PiotrOstrowski05/projekt-podnosnika-dwuramiennego/README.md

# Projekt: Ręczny podnośnik samochodowy dwuramienny

## Opis projektu
Projekt obejmuje kompleksowe opracowanie inżynierskie ręcznego podnośnika śrubowego. Proces projektowy został przeprowadzony od fazy koncepcyjnej i obliczeniowej, aż po stworzenie pełnej dokumentacji technicznej gotowej do wytworzenia.

## Zakres opracowania

### 1. Analiza teoretyczna i obliczenia
* **Wyznaczenie obciążeń:** Przeprowadzenie obliczeń analitycznych w celu określenia sił działających na poszczególne ogniwa mechanizmu w pełnym zakresie ruchu.
* **Weryfikacja wytrzymałościowa:** Dobór parametrów gwintu śruby napędowej (sprawdzenie na samohamowność i naciski powierzchniowe) oraz wymiarowanie sworzni i ramion pod kątem naprężeń gnących i ścinających.

### 2. Modelowanie CAD (Siemens NX)
* **Modelowanie bryłowe:** Stworzenie precyzyjnych modeli 3D wszystkich komponentów urządzenia.
* **Złożenie (Assembly):** Budowa struktury złożenia z uwzględnieniem więzów kinematycznych, pozwalających na symulację pracy podnośnika.
* **Dobór części znormalizowanych:** Implementacja elementów takich jak podkładki, pierścienie osadcze i elementy złączne zgodnie z normami PN/ISO.

### 3. Dokumentacja techniczna
* **Rysunki wykonawcze:** Opracowanie dokumentacji 2D dla części wymagających obróbki (np. sworznie, ramiona).
* **Rysunek złożeniowy:** Przygotowanie widoku złożeniowego wraz z naniesionymi numerami pozycji i kompletną listą części (BOM).
* **Standardy:** Uwzględnienie pasowań, tolerancji wymiarowych oraz oznaczeń chropowatości powierzchni.

## Wykorzystane narzędzia
* **Siemens NX** (CAD, Drafting)
* **Metody analityczne** (Wytrzymałość materiałów, PKM)
