PiotrOstrowski05/projekt-podnosnika-dwuramiennego/Projekt podnosnika/Raport z projektowania podnosnika/Raport z projektowania dżwignika.pdf

# PKM IV

# PROJEKT DŹWIGNIKA DWURAMIENNEGO

Wydział Mechaniczny Energetyki i Lotnictwa

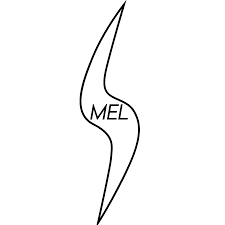
[picture p1: figure]

Piotr Ostrowski
Mechanika i Projektowanie Maszyn 333538

Sprawdzający:
mgr inż. Adam Wądołowski

## Spis treści

### 1.WSTĘP 2. STATYKA

2.1. Wyznaczenie sił działających na poszczególne ramiona i śrubę.
2.2. Rozkłady składowych wysiłku

### 3. OBLICZENIA WYTRZYMAŁOŚCIOWE

3.1. Wytrzymałość śruby
3.2. Wytrzymałość ramion
3.3. Wytrzymałość sworzni
3.4. Wytrzymałość nakrętki śruby napędowej 3.5 Wytrzymałość głowicy

### 4. DOBÓR ŁOŻYSKA WZDŁUŻNEGO 5. BIBLIOGRAFIA

### 1. WSTĘP

Celem projektu jest zaprojektowanie specjalistycznego, dwuramiennego dźwignika samochodowego, mającego za zadanie codziennej pracy w warsztacie samochodowym.

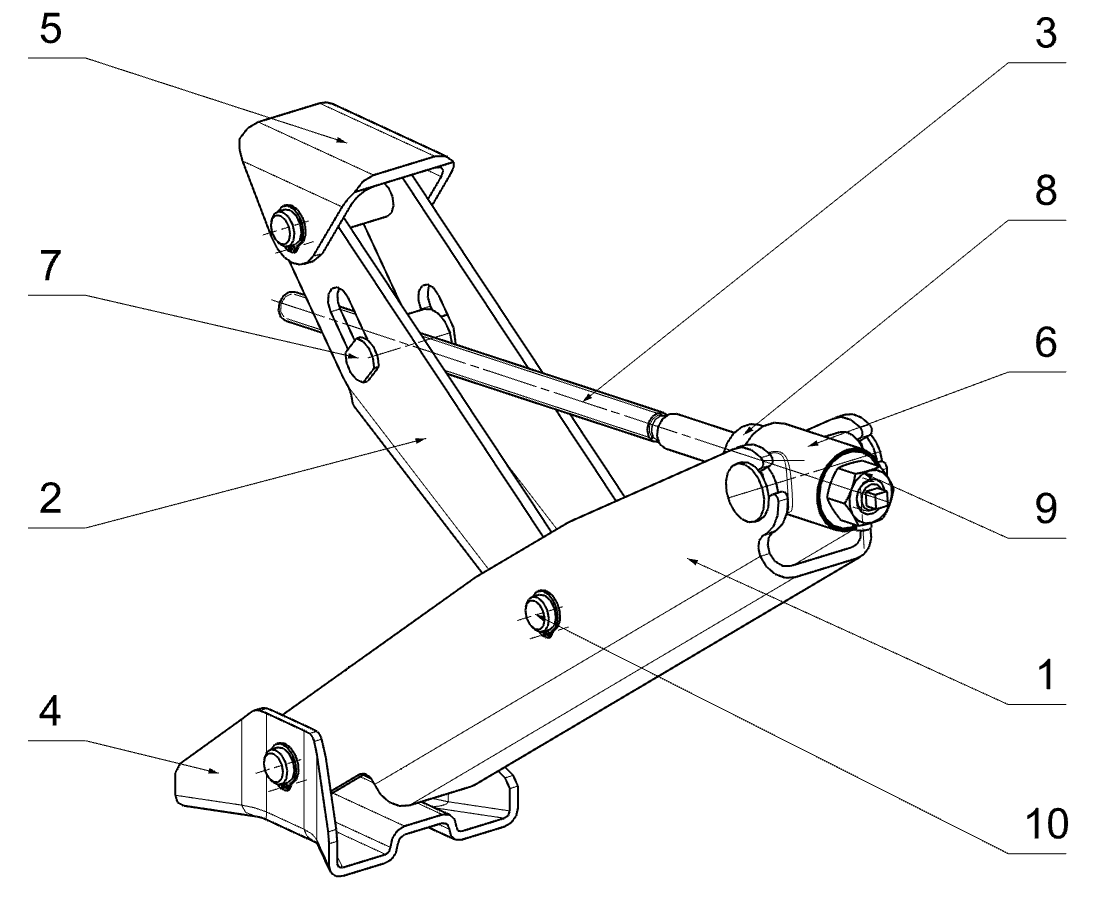
[picture p2: figure]

1 – Dłuższe ramię
2 – Krótsze ramię
3 – Śruba
4 – Podstawa
5 – Głowica
6 – Obudowa łożyska
7 - Nakrętka śruby napędzającej
8 – Pierścień osadczy
9 – Nakrętka sześciokątna (zmodyfikowana) 10 – sworzeń z pierścieniem Segera

Wymagania, które dźwignik musi spełnić:

Obciążenie maksymalne | Q | 4,4[kN]
Wysokość maksymalna | Hmax | 360[mm]
Wysokość na której dźwignik jest najbardziej obciążony | HQ | 240[mm]

Przeprowadzone obliczenia obejmują analizę wytrzymałości doraźnej oraz stateczności na wyboczenie wybranych elementów konstrukcyjnych. W obliczeniach pominięto wpływ zmęczenia materiału, przyjmując założenie, że liczba cykli pracy urządzenia jest niewielka.

Materiałem zastosowanym na ramiona jest stal C60, natomiast śruba podnośnika oraz pozostałe elementy przenoszące obciążenia wykonane są ze stali konstrukcyjnej C55. Charakterystyczne granice plastyczności materiałów wynoszą:
- stal S355J2: Re = 355 MPa
- stal S450JO: Re = 450 MPa

Ze względu na sprzyjające warunki eksploatacji, takie jak praca w środowisku warsztatowym o stabilnej temperaturze, brak niekorzystnych oddziaływań atmosferycznych oraz odpowiednie kwalifikacje personelu obsługującego, do dalszych obliczeń przyjęto współczynnik bezpieczeństwa o wartości x = 1,5.

Dźwignik w pozycji najbardziej rozłożonej

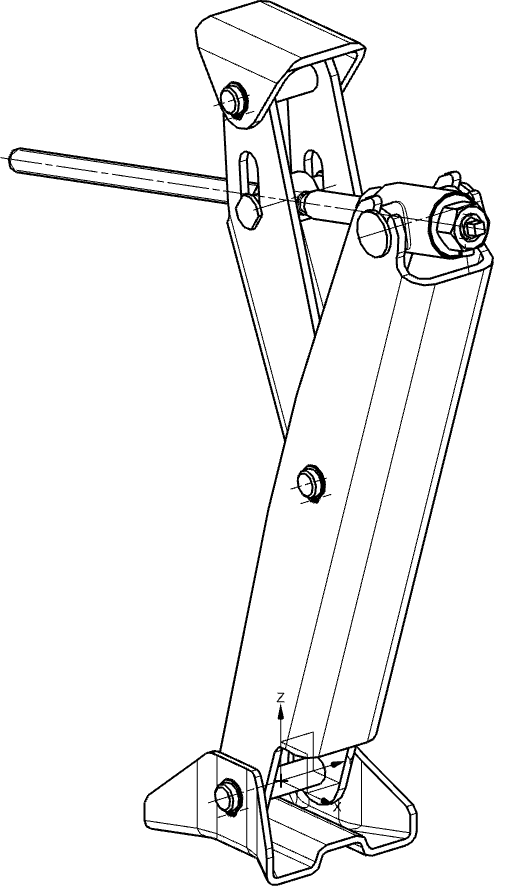
[picture p3: figure]

Dźwignik w pozycji najbardziej złożonej

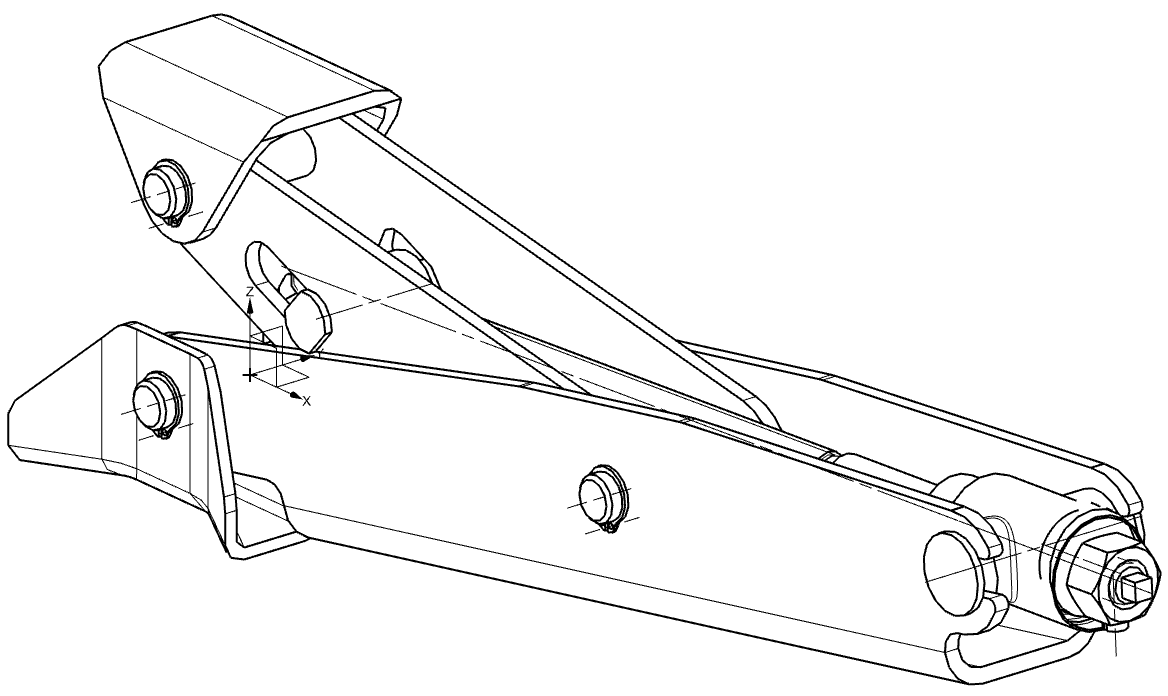
[picture p4: figure]

### 2. Statyka

2.1. Wyznaczenie sił działających na poszczególne ramiona i śrubę.

Uproszczony schemat dźwignika:

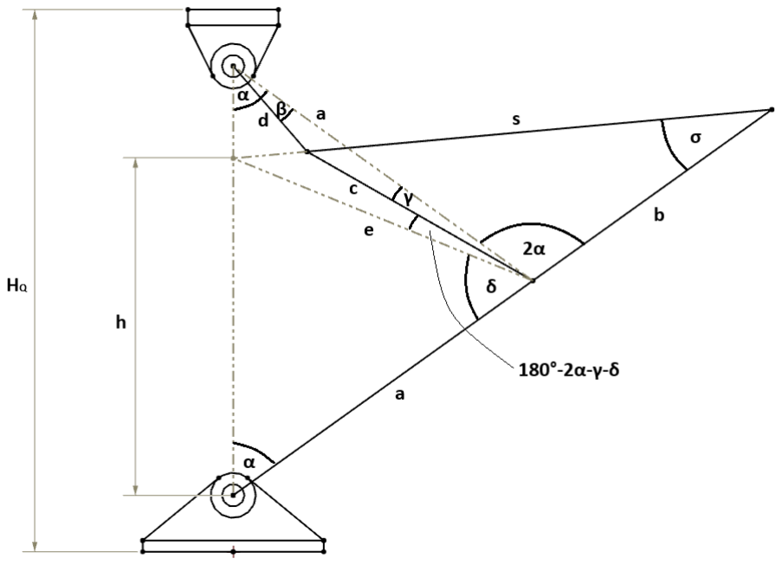
[picture p5: figure]

Obliczenia:
α = arccos(H/2)

s = √(c
2 + b

2 − 2cb cos(γ + 2α))

σ = arccos((−c

2 + s

2 + b

2
)/(2sb))

ℎ = sin(σ) ∗ (a + b)/(sin(180∘ − σ − α))

e = √(ℎ
2 + a

2 − 2ℎa cos(α))

δ = arccos((a

2 + e

2 − ℎ

2
)/(2ae))

Analiza sił obciążających dłuższe ramię

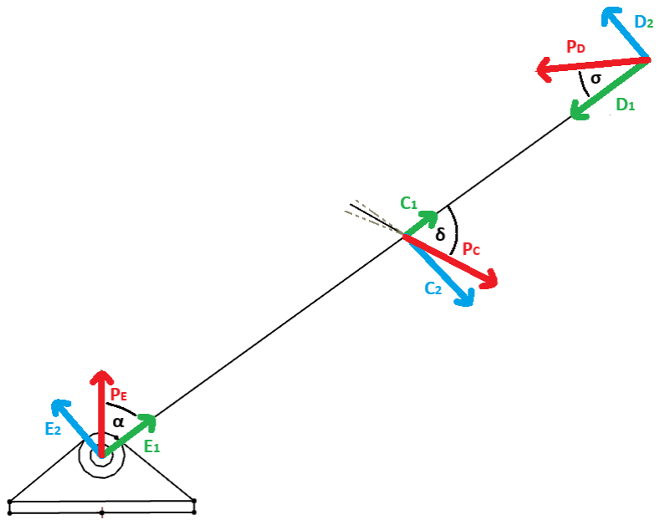
[picture p6: figure]

Ściskanie: | Ścinanie:
D1 = PD ∗ cos(σ) | D2 = PD ∗ sin(δ)
C1 = cos(δ) ∗ PC | C2 = sin(δ) ∗ PC
E1 = cos(α) ∗ Q | E2 = sin(α) ∗ Q

Analiza sił obciążających krótsze ramię

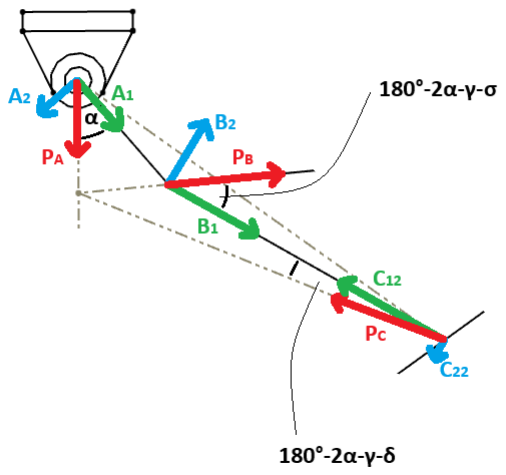
[picture p7: figure]

Ściskanie:

C12 = cos(180∘ − 2α − γ − δ) ∗ PC B1 = cos(180∘ − 2α − γ − σ) ∗ PD A1 = cos(α − β)

Ścinanie:

C22 = sin(180∘ − 2α − γ − δ) ∗ PC B2 = sin(180∘ − 2α − γ − σ) ∗ PD A2 = sin(α − β) ∗ Q

PC = (sin(α) ∗ Q ∗ (a + b))/(cos(δ) ∗ b)

PD = (sin(α) ∗ Q ∗ a)/(sin(σ) ∗ b)

Dla wychylenia dźwignika wynoszącego HQ = 240mm obliczamy siły:
A1 ≈ 3,33 [kN] | A2 ≈ 2,87 [kN]
B1 ≈ 7,25 [kN] | B2 ≈ 7,25 [kN]
C1 ≈ 5,06 [kN] | C2 ≈ 8,06 [kN]
C12 ≈ 9,43 [kN] | C22 ≈ 1,25 [kN]
D1 ≈ 7,62 [kN] | D2 ≈ 4,48 [kN]
E1 ≈ 2,56 [kN] | E2 ≈ 3,58 [kN]
PC ≈ 9,51 [kN] | PD ≈ 8,84 [kN]

Oraz maksymalne momenty gnące:
MC ≈ 0,583 [kNm]
MB ≈ 0,144 [kNm]

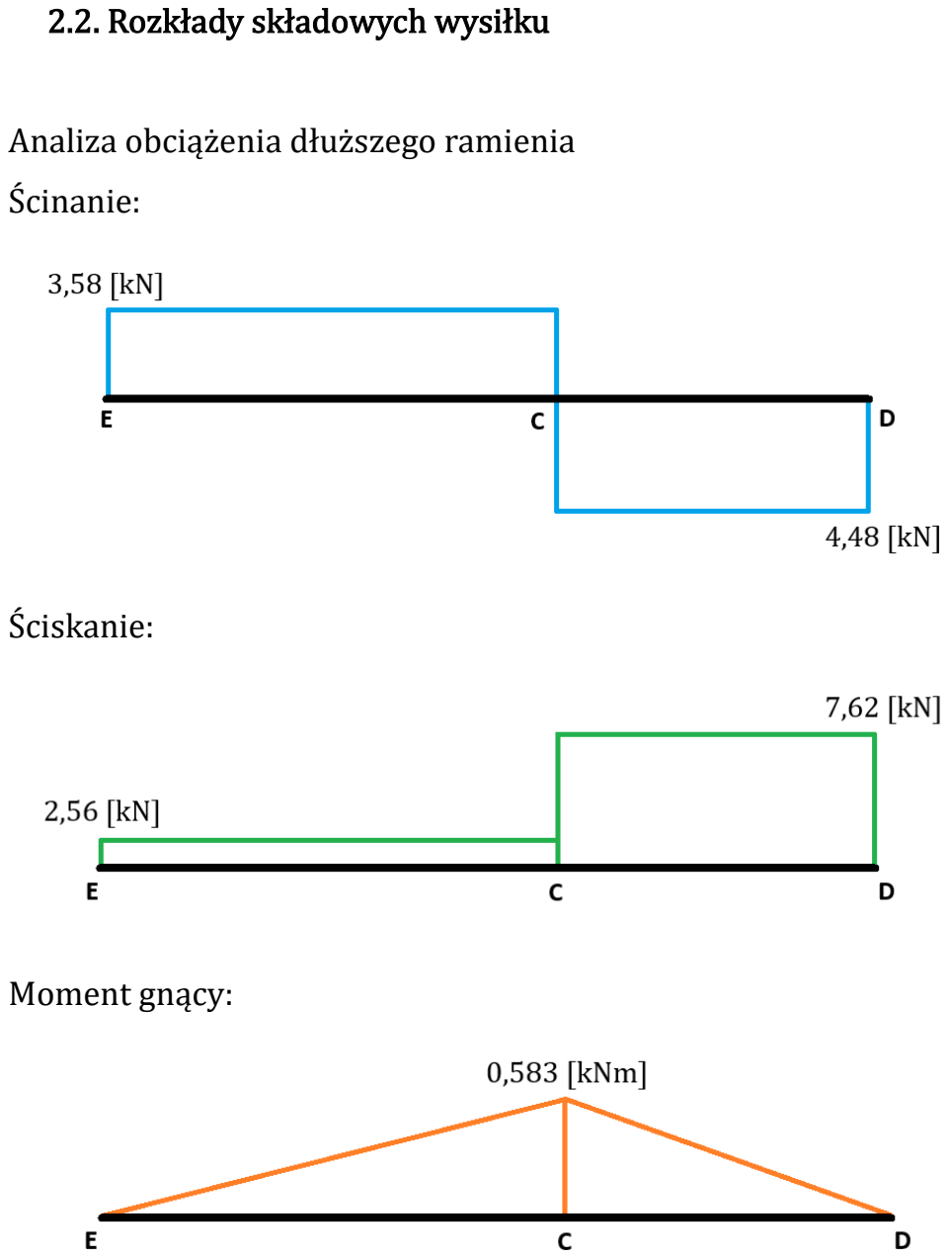
[picture p8: page 11]

2.2. Rozkłady składowych wysiłku

Analiza obciążenia dłuższego ramienia Ścinanie:

Ściskanie:

Moment gnący:

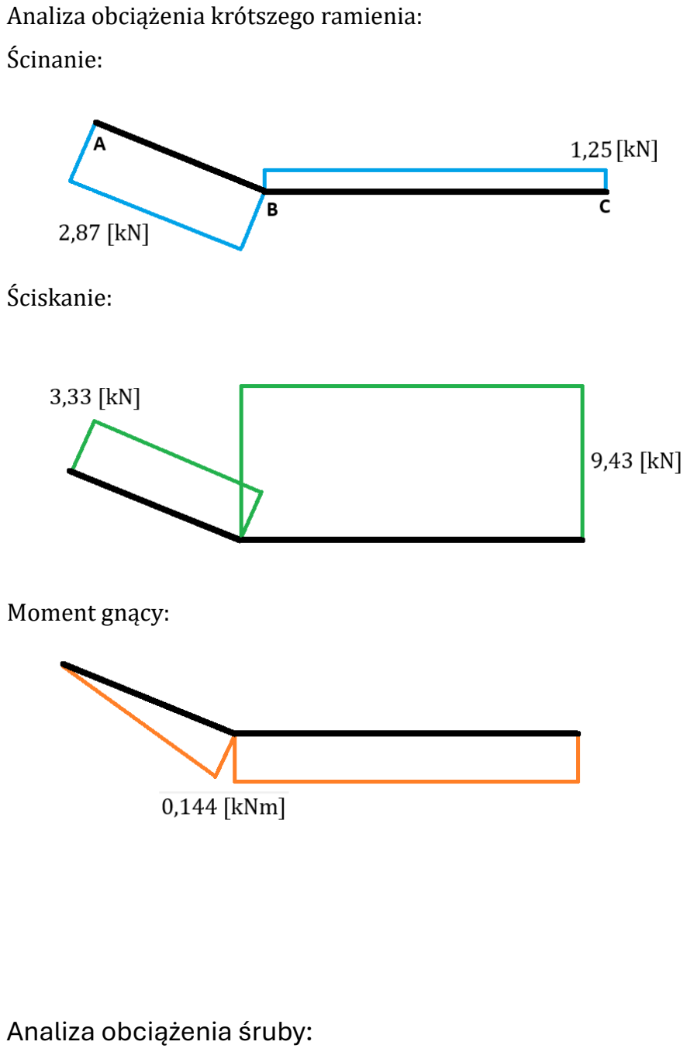
[picture p9: page 12]

Analiza obciążenia krótszego ramienia: Ścinanie:

Ściskanie:

Moment gnący:

## Analiza obciążenia śruby:

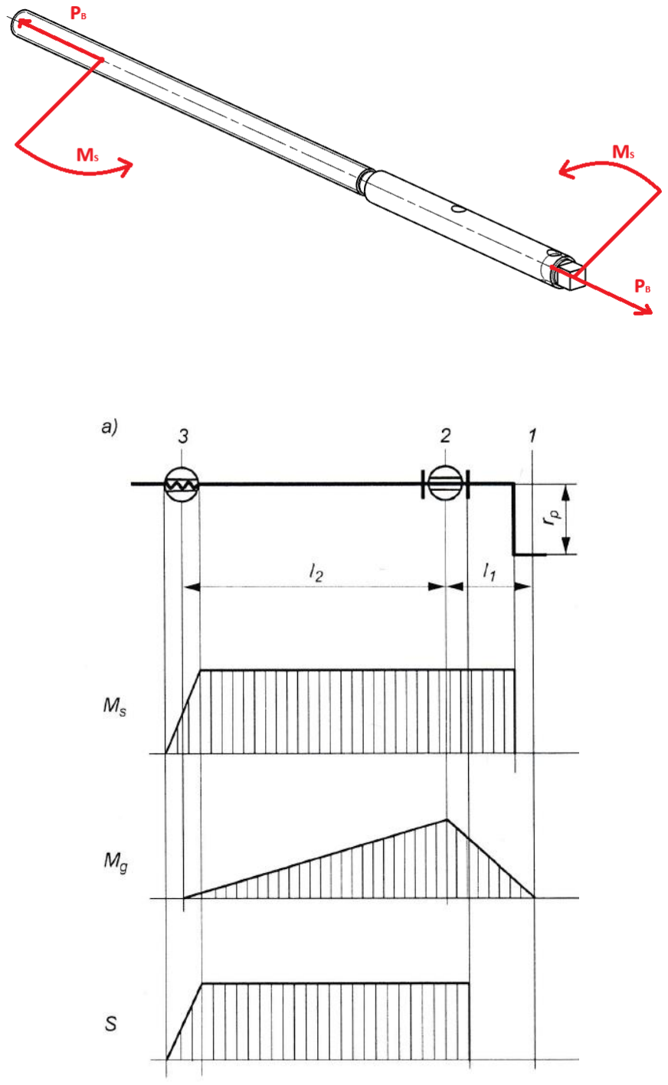
[picture p10: page 13]

3. OBLICZENIA WYTRZYMAŁOŚCIOWE
3.1. Wytrzymałość śruby
Śruba jest nagwintowana gwintem trapezowym symetrycznym.

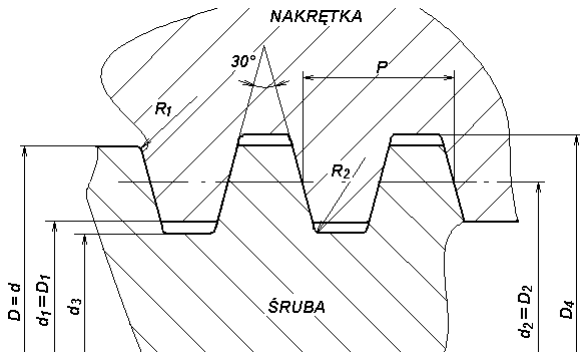
[picture p11: figure]

Jej parametry są następujące:
d = 11,0[mm] d1 = 9,5[mm] d2= 10,0[mm] d3 = 9,0[mm]
P = 2[mm] | 2αr = 30°
Aby śruba była samohamowna, parametry gwintu muszą spełniać warunek:
γ ≤ ρ

′

Gdzie:

γ = arctg (

P
| πd2

)

ρ ′ = arctg ( | μ cos αr
)

Z warunku wynika że współczynnik tarcia μ musi spełniać warunek:
μ ≥ 0,0615
Należy tak dobrać smar aby wartość współczynnika tarcia μ spełniała powyższy warunek.
Przyjmijmy do obliczeń, że smar został dobrany w taki sposób aby współczynnik tarcia wynosił około:
μ ≈ 0,15
Moment skręcający śrubę liczy się za pomocą poniższego wzoru. Ms = 0,5Sd2tg(γ + ρ

′
) ≈ 9,776[Nm]

Moment gnący wzdłuż śruby:

Mg1−2 = Prz

Mg2−3 = Prz − Pr

l1 + l2
l2

(z − l1

) = Pr (
l1
l2

(l1 + l2 − z))

Gdzie:

Pr = Ms/rp

z – zmienna oznaczająca długość Maksymalne naprężenia zredukowane w śrubie obliczamy ze wzoru:
σz = √(

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
32 )

2
+ 3 (
Ms
πdt

3

16 )

2

≤ kr =

Re
x

= 300 [MPa]

σz ≈ 221,272 [MPa] ≤ kr
Gdzie:

Mgt– moment gnący w najbardziej wrażliwym przekroju

dt

- średnica najbardziej wrażliwego przekroju
3.2. Wytrzymałość ramion
Ramię 1:
Przekrój osłabiony otworem na sworzeń:

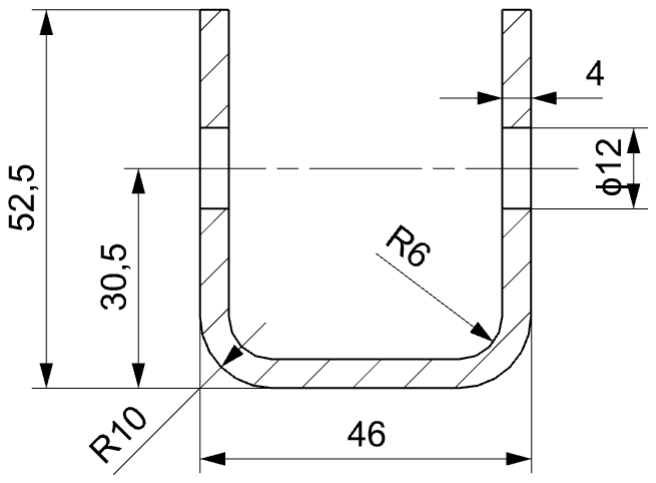
[picture p12: figure]

Na początek sprawdźmy wytrzymałość ramion na wyboczenie gięto-skrętne. Wyboczenie gięto-skrętne nie jest wymiarujące jeżeli spełniona jest zależność:

b ≤ 15g (

215
R

)

0,5

Gdzie:
b – szerokość półki kształtownika,
g – grubość półki kształtownika,
R – wytrzymałość obliczeniowa materiału kształtownika.

R =

Re

γs

[MPa]

γs = 1,15 dla stali o Re ≤ 355 [MPa]

b = 42,5 [mm] ≤ 15g (

215
R

)

0,5
≈ 50,07[mm]

Więc wyboczenie gięto skrętne nie wymiaruje.

Stateczność miejscowa nie jest wymiarująca jeżeli spełniony jest warunek:

λ

∗ ≤ ϕ (

215
R

)

0,5

Gdzie:
λ

∗ = 3b/g - dla ceownika

ϕ = 60 - przy osiowym ściskaniu
ϕ = 90 − 30ψ - przy mimośrodowym ściskaniu
ψ = σ2/σ1 -stosunek naprężeń krawędziowych półki, przy czym |σ1

| > |σ2

W tym przypadku mamy do czynienia ze ściskaniem w przybliżeniu osiowym. Przyjmijmy φ = 60, nawet wtedy warunek jest spełniony.

λ

∗ ≈ 31,875 ≤ φ (

215
R

)

0,5
≈ 50,049

Warunek spełniony, więc stateczność miejscowa nie wymiaruje.

Elementy ściskane oblicza się na wyboczenie giętne, gdy ich smukłość:
λ > 0,2λp

Gdzie:

λp =

1675
(R)

0,5

λ = lw/i lw - długość wyboczeniowa, dla prętów mocowanych na obu końcach przegubowo, równa długości teoretycznej, to jest odległości między osiami przegubów
λp - smukłość porównawcza, dla stali miękkich λp ∈ (100,128)

i - promień bezwładności przekroju, i = (J/Fbr)

0,5

J - minimalny moment bezwładności przekroju, w przypadku ceownika na ogół względem osi równoległej do jego środnika Fbr - pole przekroju brutto, to jest z pominięciem ewentualnych otworów
λ ≈ 10,986 > 0,2λp ≈ 19,067

Warunek nie spełniony więc nie obliczamy ramienia na wyboczenie gięte.

Sprawdzimy wytrzymałość ramienia 1 na zginanie. Moment maksymalny jakim obciążone jest ramię wynosi:

Mgmax = Mg1 + Mg2

Mg1 - moment powstały w skutek działania siły składowej prostopadłej

do ramienia
Mg2 - moment powstały w skutek działania siły ściskającej na ramieniu

Mimośrodu
Mg1 ≈ 0,583[kNm]

Mg2 = eD1 ≈ 0,092[kNm]

Mgmax ≈ 0,674[kNm]

e – mimośród (odległość działania siły od osi obojętnej na zginanie)

D1 – siła osiowa
Moment bezwładności przekroju w maksymalnie obciążonym miejscu wynosi:
I = 1,199 ⋅ 10⁻⁷

[mm⁴
]
Do tego naprężenia ściskające:

σ =

D1
Ap

≈ 5,717[MPa]

Ap − pole przekroju

Dają w sumie:
σmax ≈ 100,036[MPa]
Ramiona zbudowane są ze stali S355J2 o Re=355[MPa] więc zapas bezpieczeństwa wynosi:

kw =

σmax
Re

≈ 1,78 ≥ x

Więc konstrukcja jest bezpieczna.

Ramię 2:
Ramię drugie jest zdecydowanie mniej obciążone. Najbardziej obciążony, w stosunku do pola przekroju oraz momentu bezwładności przekroju, jest poniższy przekrój:

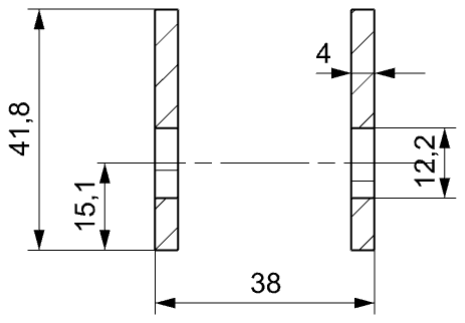
[picture p13: figure]

Sprawdźmy ramię ze względu na wyboczenie.
Wyboczenie gięto-skrętne, dla przekrojów otwartych nie jest wymiarujące, jeżeli spełniona jest zależność:

b ≤ 15g (

215
R

)

0,5

R =

Re

γs

[MPa]

γs = 1,15 dla stali o Re ≤ 355 [MPa]

b = 42,5 [mm] ≤ 15g (

215
R

)

0,5
≈ 50,07[mm]

Więc wyboczenie gięto skrętne nie wymiaruje.

Stateczność miejscowa nie jest wymiarująca jeżeli spełniony jest warunek:

λ

∗ ≤ ϕ (

215
R

)

0,5

Gdzie:
λ

∗ = H/g - dla płaskownika

ϕ = 60 - przy osiowym ściskaniu
ϕ = 90 − 30ψ - przy mimośrodowym ściskaniu
ψ = σ2/σ1 -stosunek naprężeń krawędziowych półki, przy czym |σ1

| > |σ2

Znowu możemy przyjąć ϕ = 60, ponieważ warunek i tak będzie spełniony.

λ

∗ ≈ 10,450 ≤ ϕ (

215
R

)

0,5
≈ 50,049

Wynika z tego, że stateczność miejscowa nie wymiaruje.

Elementy ściskane oblicza się na wyboczenie giętne, gdy ich smukłość:
λ > 0,2λp

Gdzie:

λp =

1675
(R)

0,5

λ = lw/i
lw - długość wyboczeniowa, dla prętów mocowanych na obu końcach przegubowo, równa długości teoretycznej, to jest odległości między osiami przegubów λp - smukłość porównawcza, dla stali miękkich λp ∈ (100,128)

i - promień bezwładności przekroju, i = (J/Fbr)

0,5

J - minimalny moment bezwładności przekroju, w przypadku ceownika na ogół względem osi równoległej do jego środnika Fbr - pole przekroju brutto, to jest z pominięciem ewentualnych Otworów
λ ≈ 8,038 > 0,2λp ≈ 19,067

Do analizy tego warunku będziemy potrzebowali dodatkowo innego przekroju. Poniższy przekrój posiada najmniejszy moment bezwładności przekroju w ramieniu.

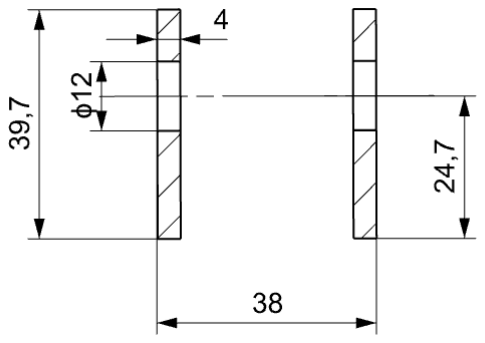
[picture p14: figure]

λ ≈ 3,528 > 0,2λp ≈ 19,067

Warunek w obu przekrojach nie jest spełniony więc nie obliczamy ramienia na wyboczenie gięte.

Sprawdźmy ramię 2 pod względem wytrzymałości na zginanie

Mgmax = Mg1 + Mg2

Mg1 - moment powstały w skutek działania siły składowej prostopadłej

do ramienia
Mg2 - moment powstały w skutek działania siły ściskającej na ramieniu

Mimośrodu
Mg1 ≈ 0,144[kNm]

Mg2 = eB1 ≈ 0,060[kNm]

Mgmax ≈ 0,204[kNm]

Moment bezwładności przekroju w maksymalnie obciążonym miejscu wynosi:
I = 6,845 ⋅ 10⁻⁸

[mm⁴
]
Do tego naprężenia ściskające:

σ =

B1
Ap

≈ 30,728[MPa]

Ap − pole przekroju

Dają w sumie:
σmax ≈ 199,854[MPa]
Ramiona zbudowane są ze stali S355J2 o Re=355[MPa] więc zapas bezpieczeństwa wynosi:

kw =

σmax
Re

≈ 3,55 ≥ x

Więc konstrukcja jest bezpieczna.

3.3. Wytrzymałość sworzni
W dźwigniku zostały użyte sworznie wykonane ze stali nierdzewnej o oznaczeniu A2. Rowek na pierścień blokujący został wykonany według normy DIN471. Pierścień blokujący również został dobrany zgodnie z normą DIN471.
Przeanalizujmy wytrzymałość sworzni.
Sworznie obciążone są w następujący sposób:

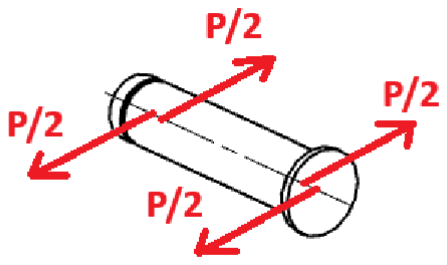
[picture p15: figure]

Wszystkie sworznie mają taką samą średnicę, więc przeanalizujmy ten najbardziej obciążony.
P = PC = 9,51[kN]
Zacznijmy od nacisków powierzchniowych.

p =

P
2gd ≤ pdop

Gdzie:
pdop = 0,5Re = 177,5[MPa]

Naprężenia dopuszczalne liczymy dla materiału o mniejszej wytrzymałości. Wytrzymałość Re stali A2 to około 450[MPa], więc do obliczeń, wybieramy stal S355J2.

p =

P
2gd

≈ 99,1[MPa] ≤ pdop = 177,5[MPa]

Warunek spełniony. Teraz sprawdźmy warunek na ścinanie przekroju.

τ =

2P
πd

2

≈ 42,1[MPa] ≤ 0,6

Re
x

≈ 142,0[Mpa]

Warunek spełniony. Sworznie zostały dobrane bezpiecznie.

3.4. Wytrzymałość nakrętki śruby napędowej
Nakrętka do śruby napędowej jest obciążona w następujący sposób:

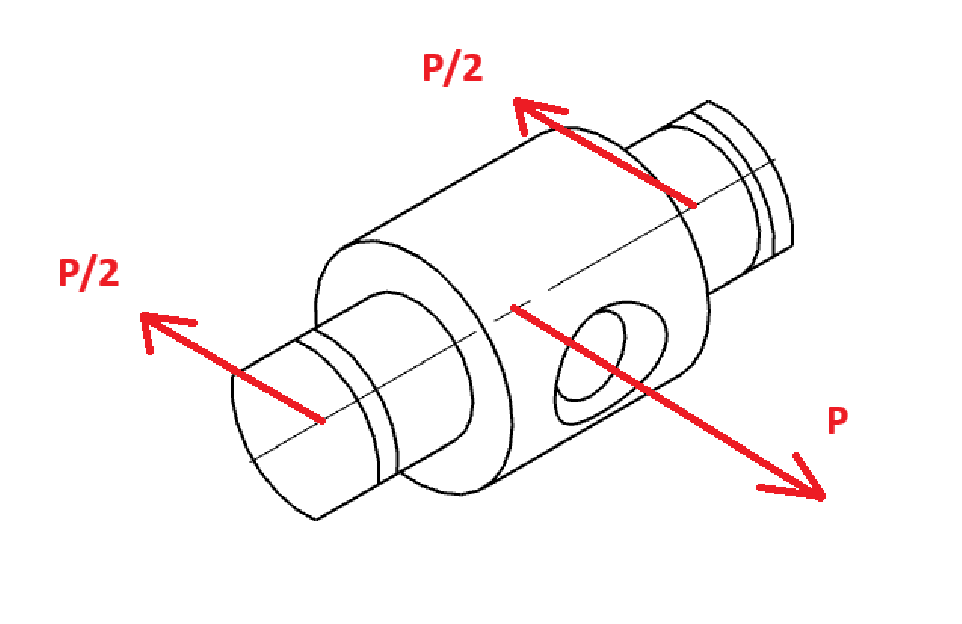
[picture p16: figure]

P = PD ≈ 8,84 [kN]

Sprawdźmy naciski.

p =

P
2gd

≈ 92,1[MPa] ≤ pdop = 177,5[MPa]

Teraz warunek na ścinanie.

τ =

2P
πd

2

≈ 39,1[MPa] ≤ 0,6

Re
x

≈ 142,0[Mpa]

Warunki spełnione.
Przekrój najbardziej narażony na zginanie wygląda następująco:

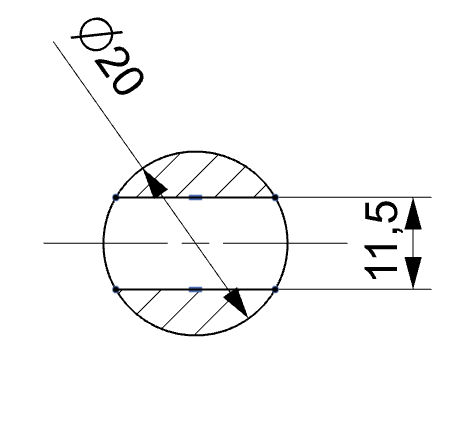
[picture p17: figure]

Moment bezwładności przekroju wynosi: I ≈ 7,225 ∗ 10^3[mm⁴
]
Moment zginający to:
Mg ≈ 128,2[Nm]

σ ≈ 177,4 [MPa] < Re/x ≈ 236,7[MPa]

Nakrętka śruby napędzającej została zaprojektowana bezpiecznie.

3.5 Wytrzymałość głowicy
Głowica została zaprojektowana tak aby przenosić obciążenie rozkładające się na całej jej powierzchni górnej. Naciski na tej powierzchni nie powinny przekraczać 5[MPa].
Zakładając że naciski rozkładają się równomiernie na całej powierzchni górnej głowicy można obliczyć naciski.
Siła obciążająca głowicę ma wartość Q = 4,4[kN] Powierzchnia górna głowicy to A = 0,00156[mm²
]

Zatem naciski to:
p = Q/A ≈ 2,82[MPa] < 5[MPa]

Warunek spełniony.

### 4. DOBÓR ŁOŻYSKA WZDŁUŻNEGO

Łożysko zostało dobrane tak aby miało nośność statyczną C0 > PD oraz aby średnica wewnętrzna, która została osadzona na wale, miała średnicę 12[mm].

Do założeń idealnie pasuje łożysko SKF51101 o nośności statycznej ok. 16[kN].

### BIBLIOGRAFIA:

- Podstawy konstrukcji maszyn: projektowanie 1/ Korytkowski, Bohdan
