PiotrOstrowski05/projekt-podnosnika-dwuramiennego/Projekt podnosnika/Dokumentacja 2D Podnosnika/Dokumentacja_2D_obudowa_lozyska.pdf

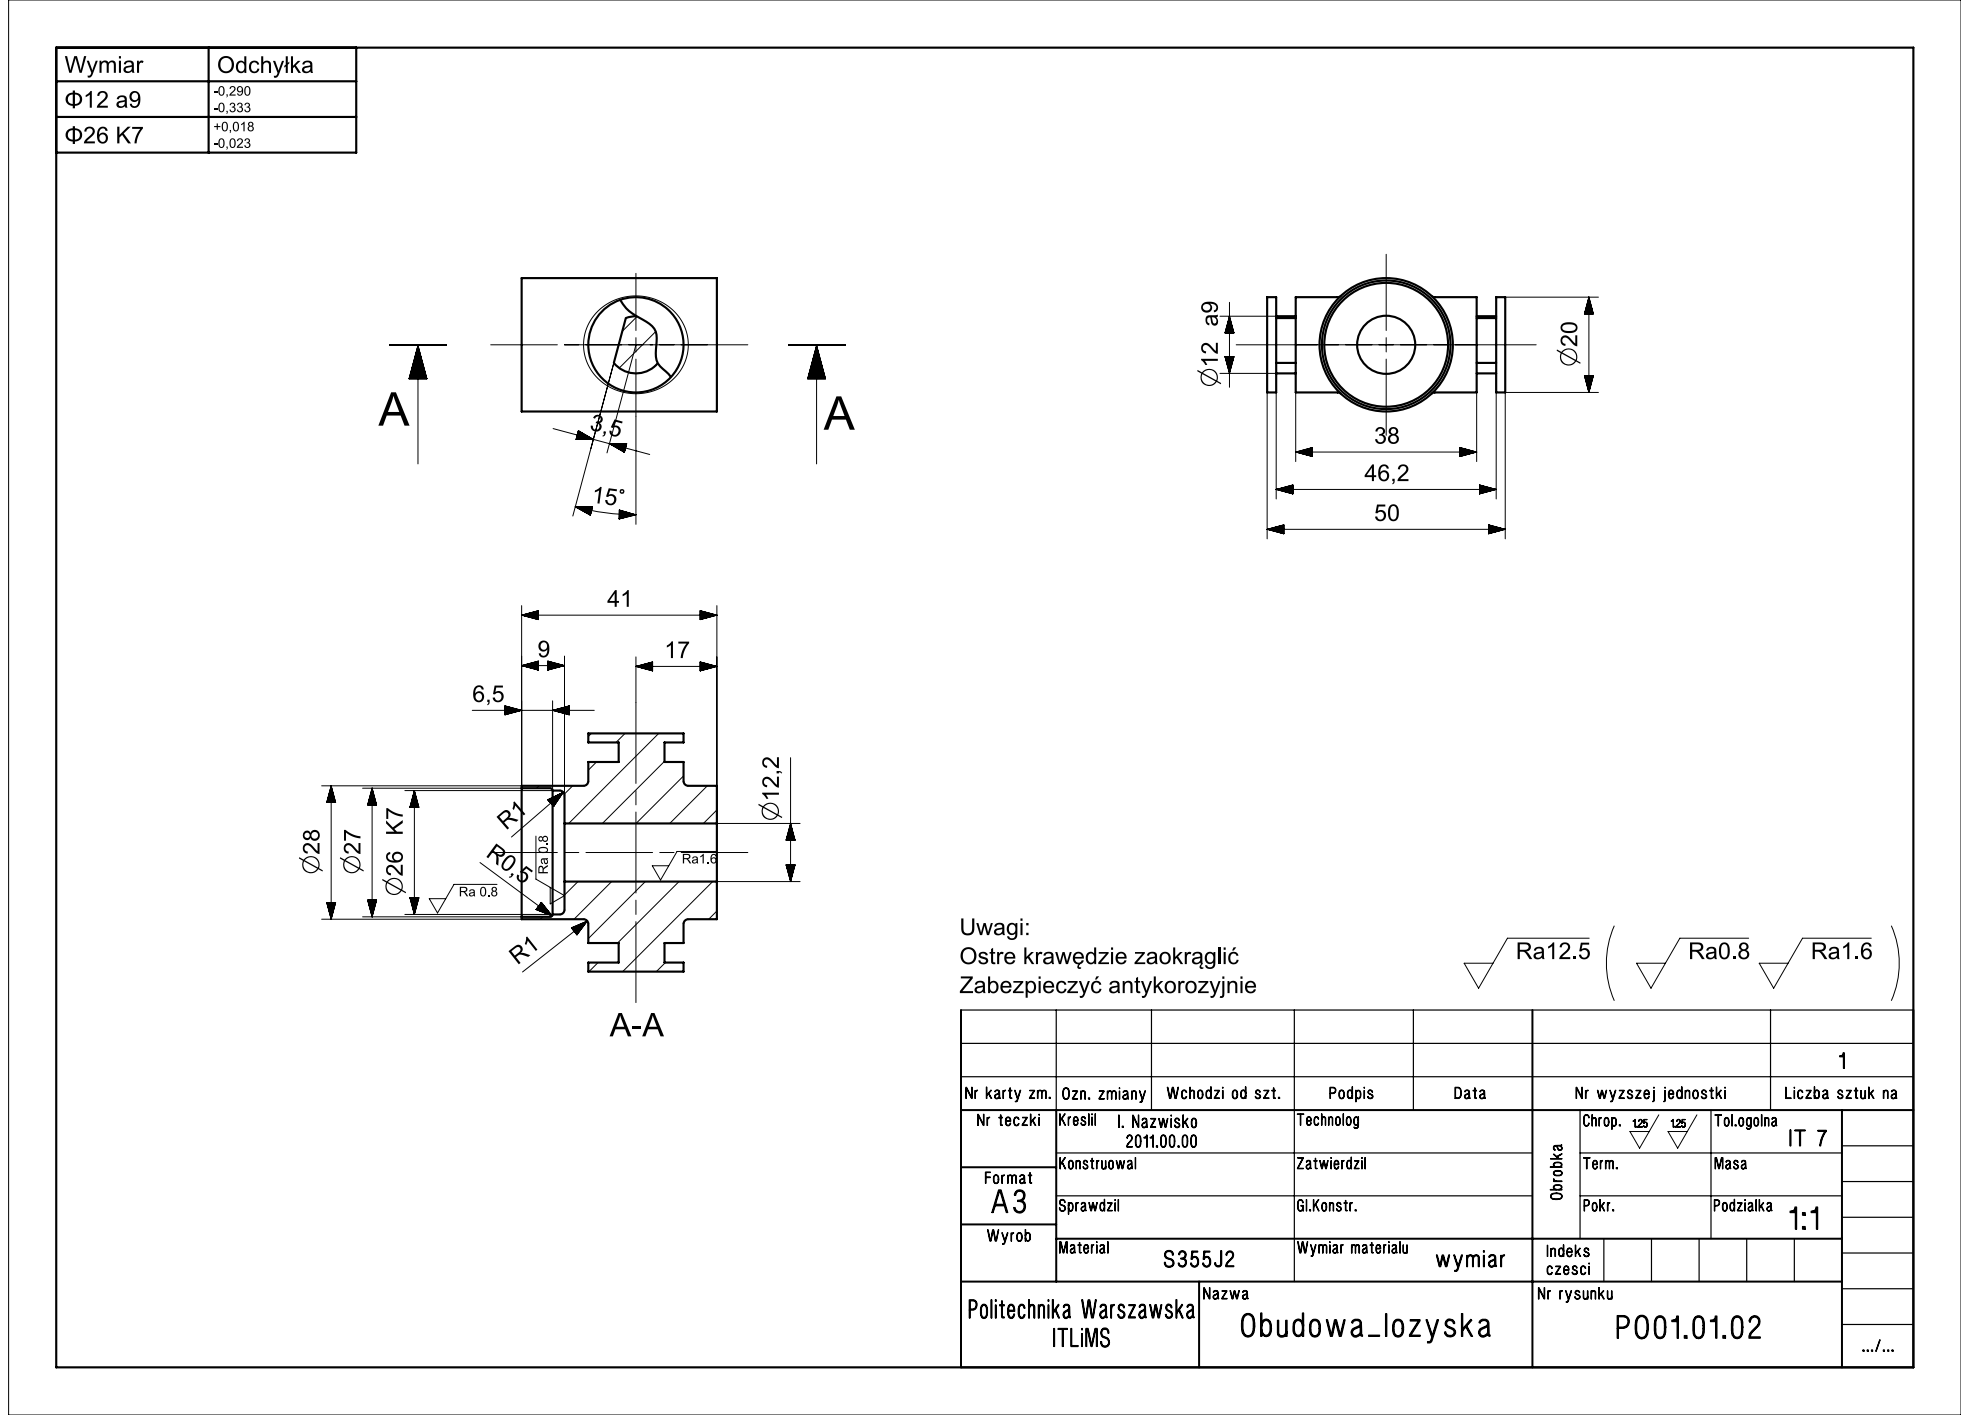
[picture p18: page 1]
