PiotrOstrowski05/projekt-podnosnika-dwuramiennego/Projekt podnosnika/Dokumentacja 2D Podnosnika/Dokumentacja_2D_sruba_trapezowa.pdf

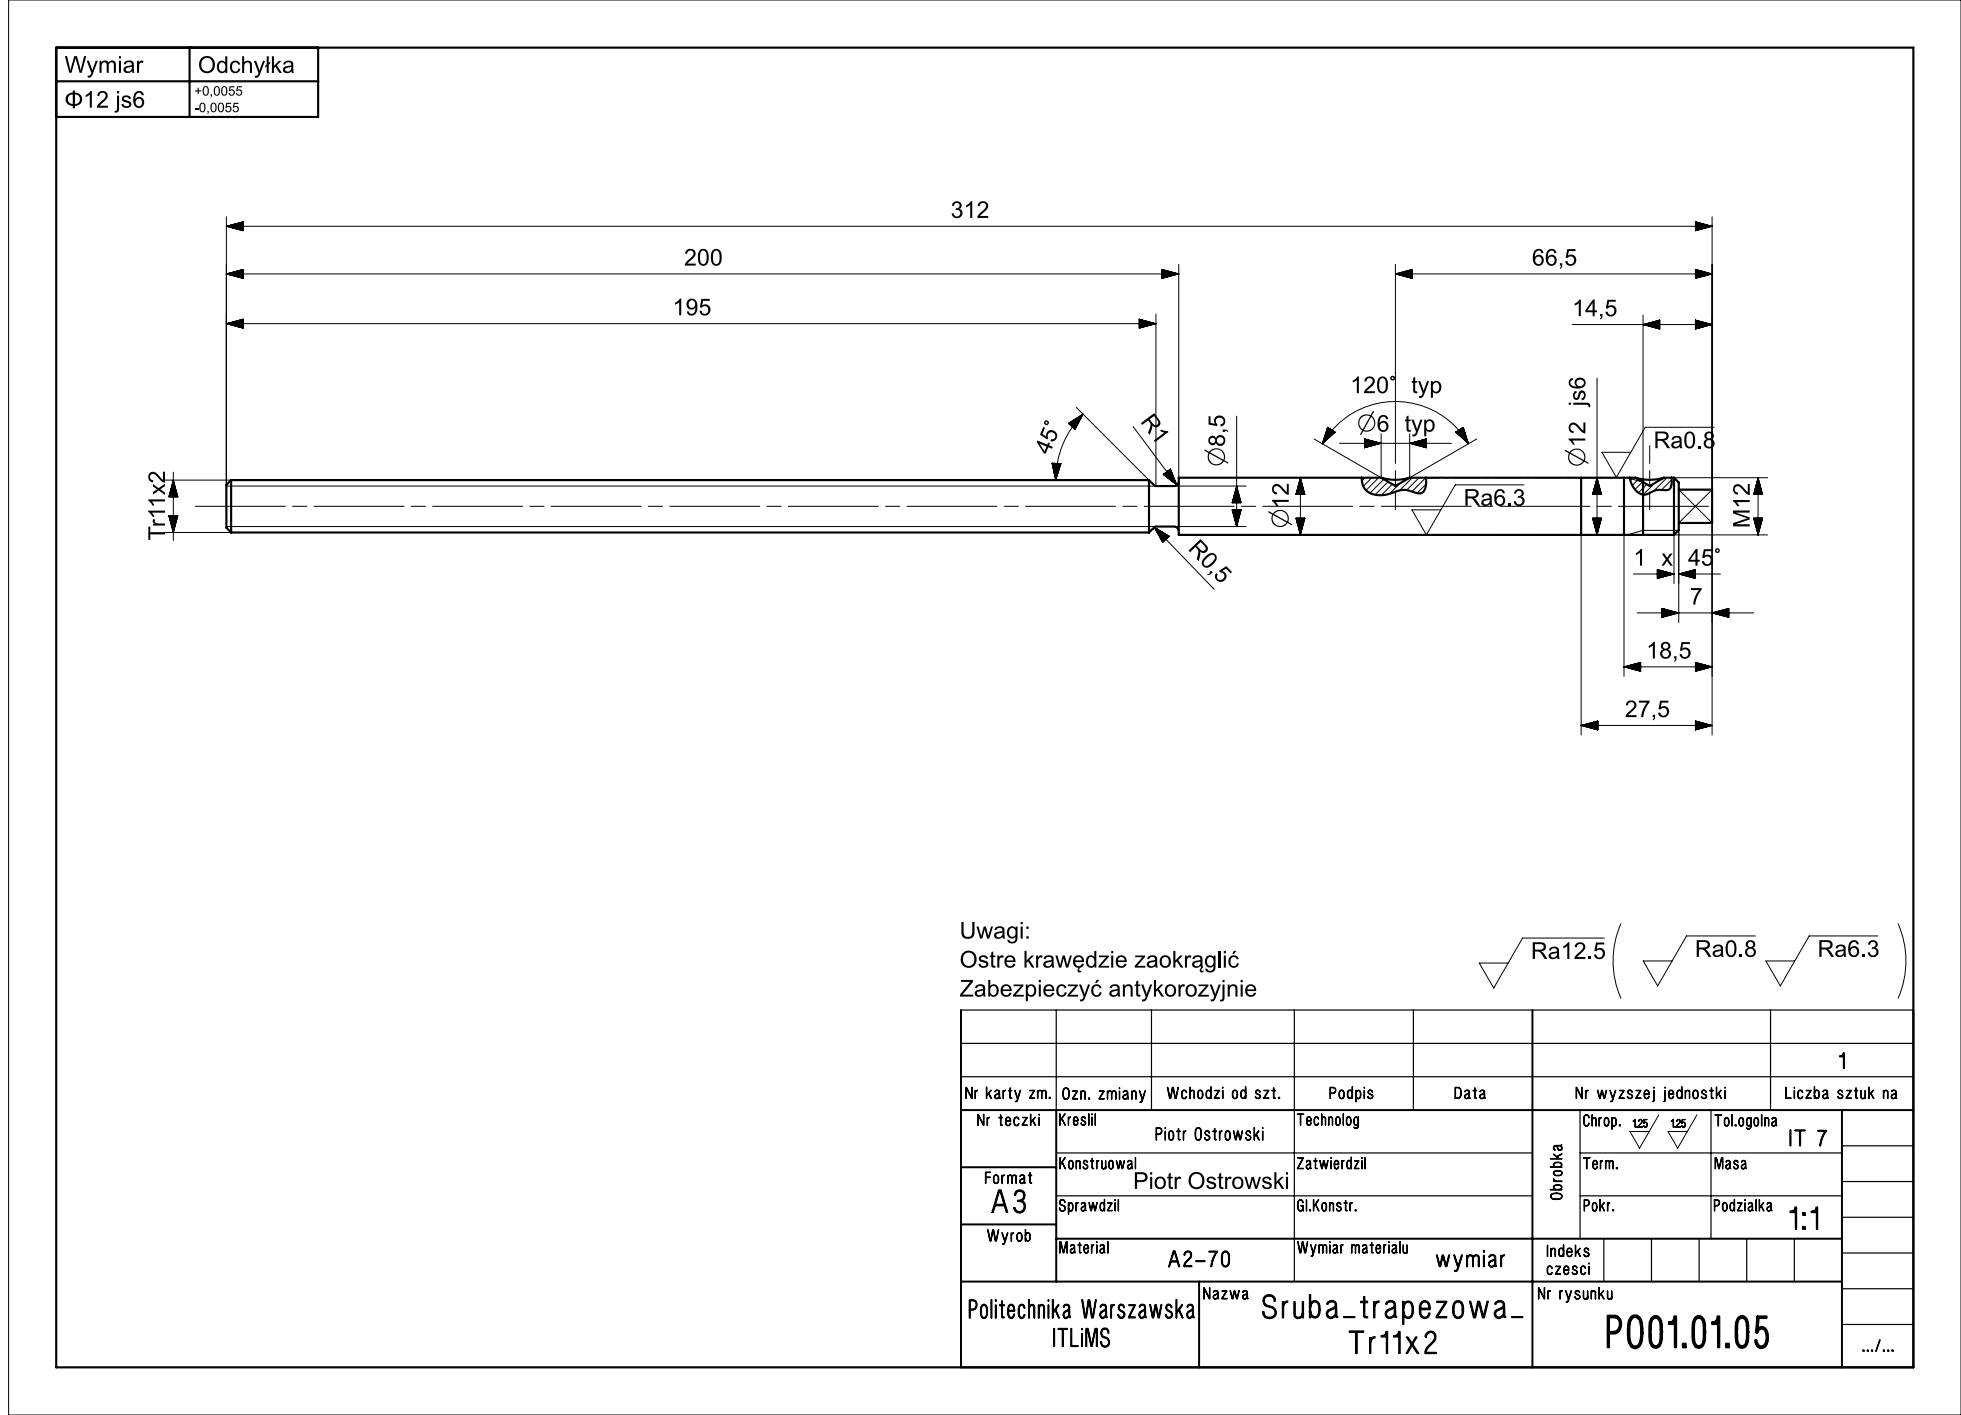
[picture p19: page 1]
