PiotrOstrowski05/projekt-podnosnika-dwuramiennego/Projekt podnosnika/Dokumentacja 2D Podnosnika/Dokumentacja_2D_zlozenie_podnosnika.pdf

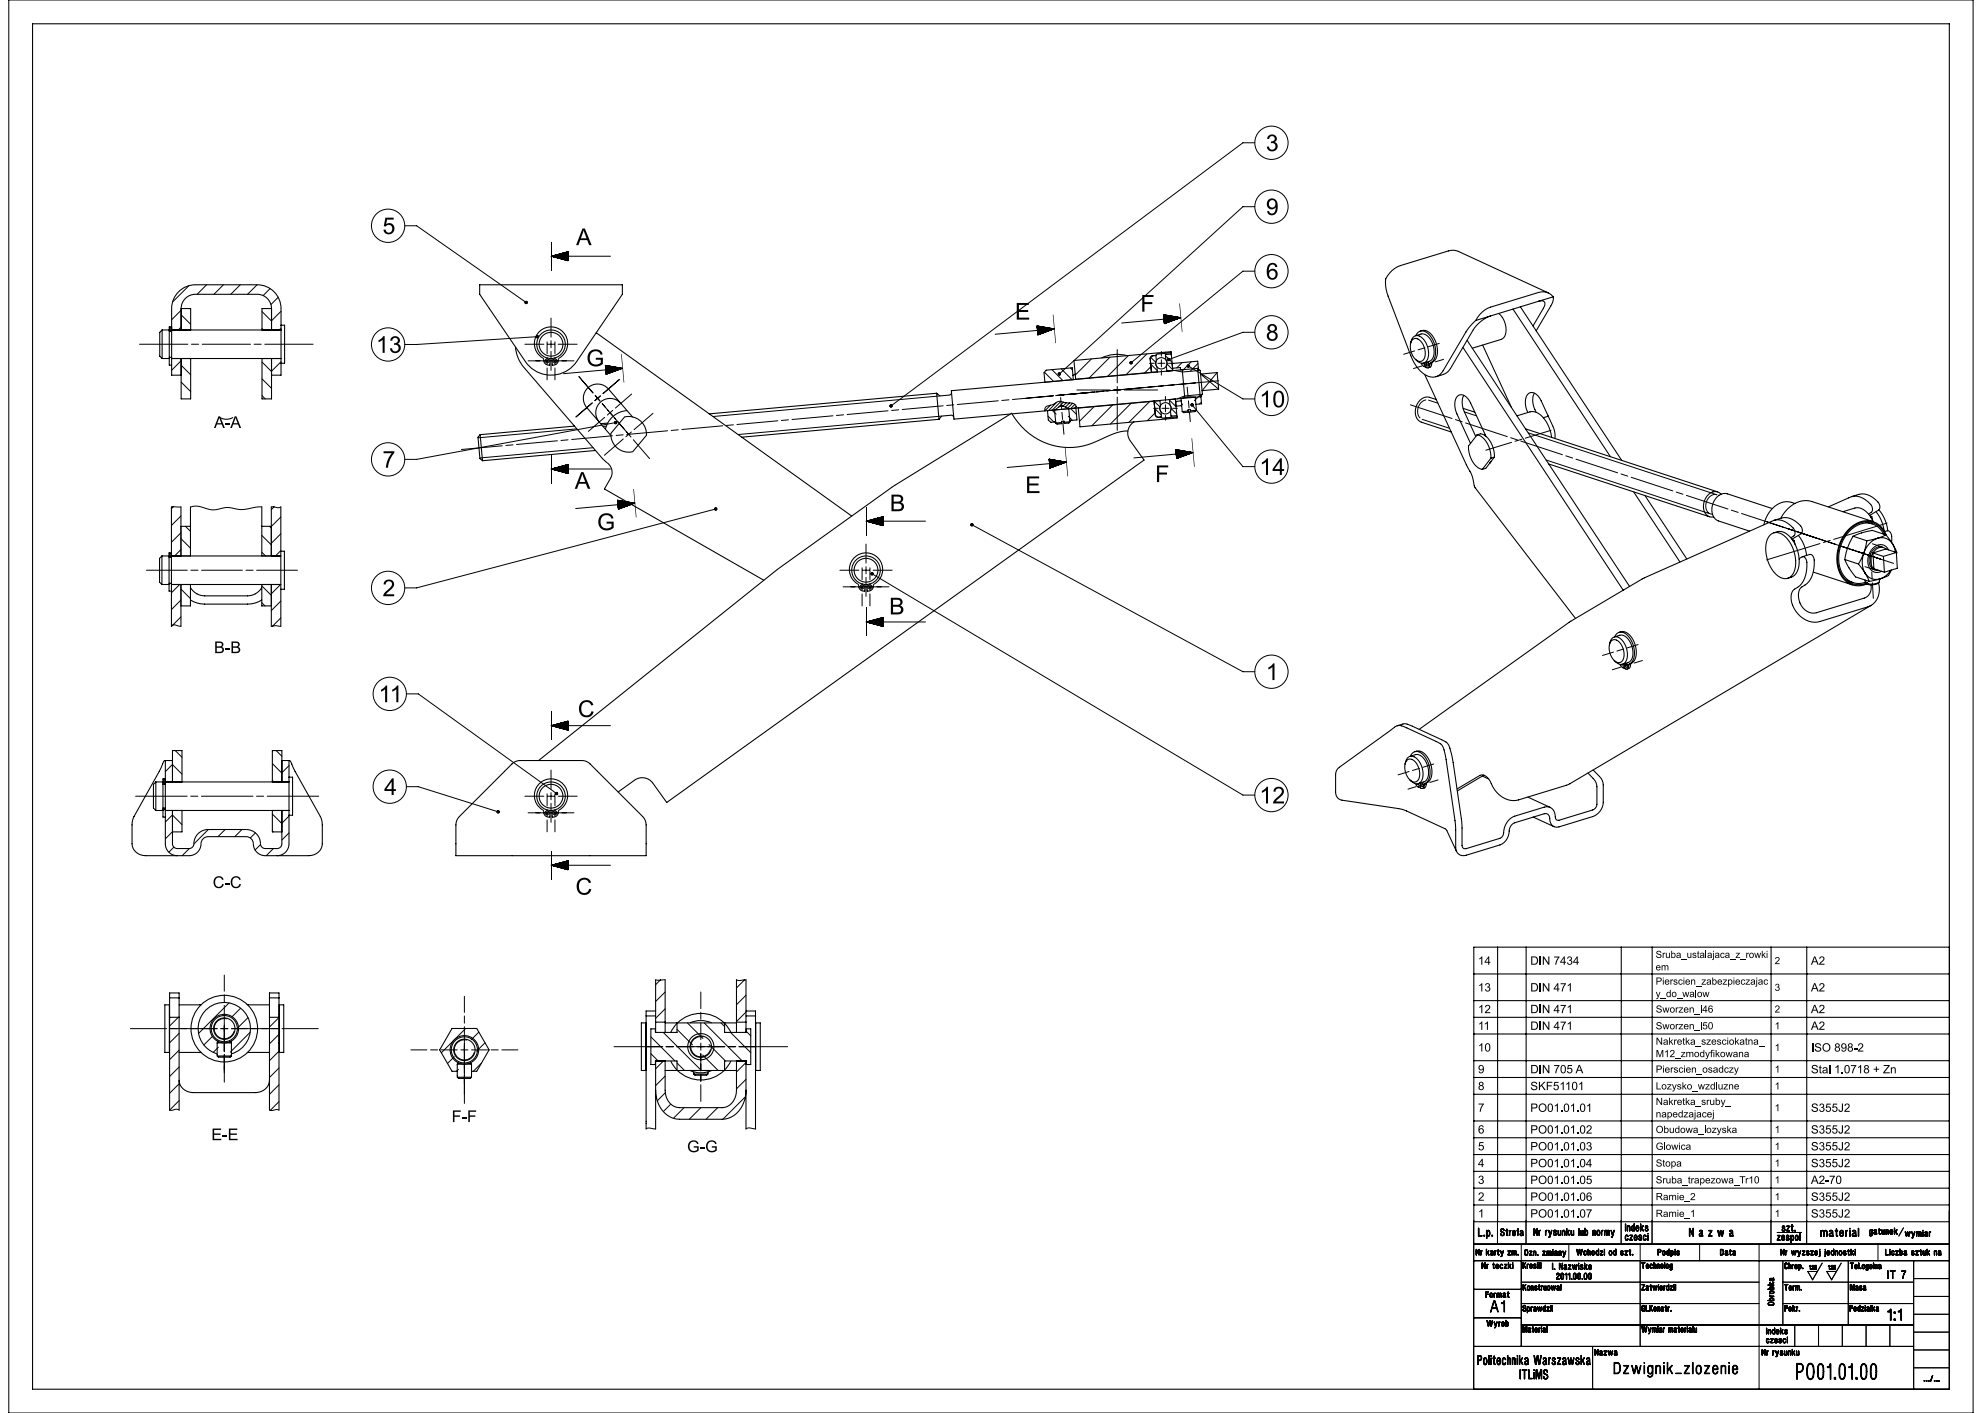
[picture p20: page 1]
