PiotrOstrowski05/projekt-podnosnika-dwuramiennego/(list of files, cad)

Other CAD files:
Projekt podnosnika/Dokumentacja 2D Podnosnika/Dokumentacja_2D_obudowa_lozyska.prt
Projekt podnosnika/Dokumentacja 2D Podnosnika/Dokumentacja_2D_sruba_trapezowa_Tr12.prt
Projekt podnosnika/Dokumentacja 2D Podnosnika/Dokumentacja_2D_zlozenie_podnosnika.prt
Projekt podnosnika/Modele 3D Podnosnika/Dzwignik_dwuramienny_zlozenie.prt
Projekt podnosnika/Modele 3D Podnosnika/lozysko_kulkowe_wzdluzne_fi12.prt
Projekt podnosnika/Modele 3D Podnosnika/nakretka_sruby_napedowej.prt
Projekt podnosnika/Modele 3D Podnosnika/obudowa_lozyska.prt
Projekt podnosnika/Modele 3D Podnosnika/pierscien_osadczy_zaciskowy_fi12.prt
Projekt podnosnika/Modele 3D Podnosnika/pierscien_segera_z12.prt
Projekt podnosnika/Modele 3D Podnosnika/ramie_1.prt
Projekt podnosnika/Modele 3D Podnosnika/ramie_2.prt
Projekt podnosnika/Modele 3D Podnosnika/sruba_trapezowa_Tr10.prt
Projekt podnosnika/Modele 3D Podnosnika/sruba_ustalajaca_z_rowkiem_M6.prt
Projekt podnosnika/Modele 3D Podnosnika/stopa.prt
Projekt podnosnika/Modele 3D Podnosnika/sworzen1.prt
Projekt podnosnika/Modele 3D Podnosnika/sworzen3.prt
